Bot-Ro-Bot/Minor-Year-Project/Installation Photos/20190805_160726.jpg

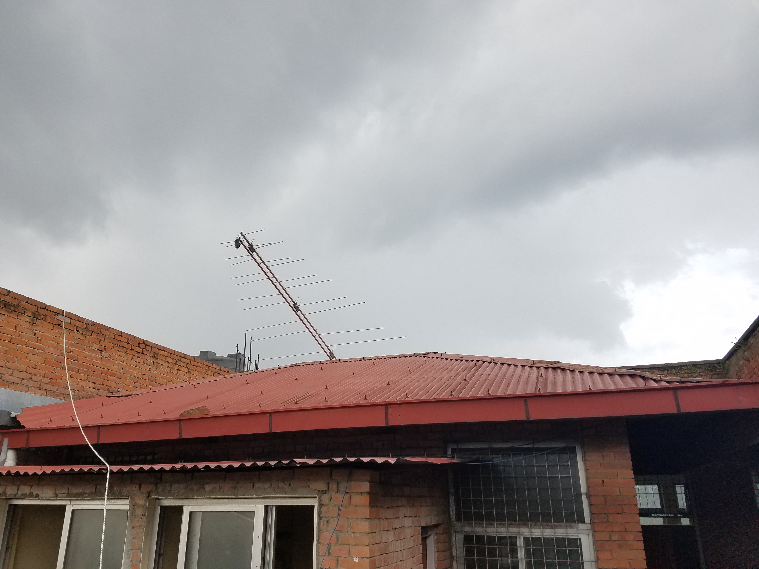
Installation Photos/20190805_160726.jpg
