Bot-Ro-Bot/Minor-Year-Project/Installation Photos/20190728_180228.jpg

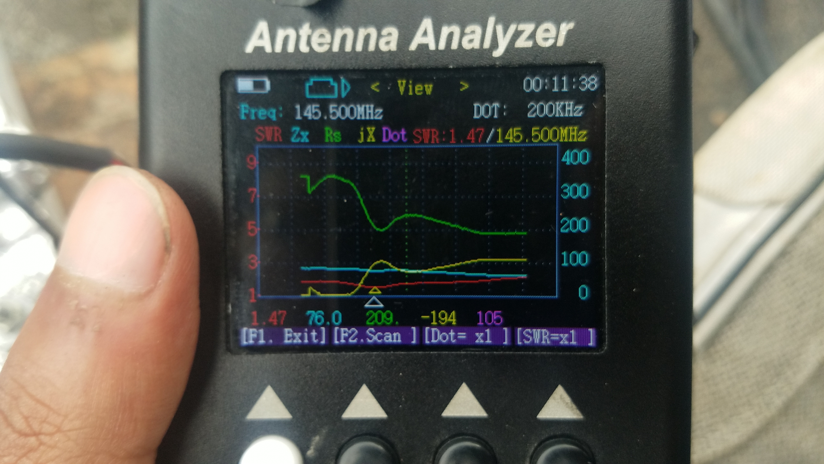
Installation Photos/20190728_180228.jpg
