Bot-Ro-Bot/Minor-Year-Project/Documentation/Proposal Defence.pptx

## Visualization of Solar Spectrum

Team members:
Rabin Nepal [073/BEX/331]
Rimesh Lawgun [073/BEX/333
Sanjay Rijal [073/BEX/342]
Upendra Subedi [073/BEX/347]

## Presentation Outline

- Motivation
- Objectives
- Scope of the Project
- Proposed Methodology
  - Instrumentation
    - Hardware
    - Software
- Expected Result
- Project Application
- Tentative Timeline
- Tentative Project Budget
- References

## Motivation

- e-Callisto project.
- Solar radiation and Aerosol in Himalaya Region (SAHR).
- Solar and Wind Energy Resource Assessment in Nepal (SWERA).

## Objectives

- To design and develop an instrumentation system for measuring solar irradiance.
- To analyze the relationship of solar irradiance with frequency and time.

## Scope of Project

- Weather forecasting.
- Solar Radiation Management (SRM).

## Proposed Methodology

- System Block Diagram:
Fig: System Block Diagram

Amplifier circuit

Filter circuit

Antenna

ADC

MatLab

Microcontroller

## Proposed Methodology [Contd..]

- Instrumentation:
  1. Hardware:
    a. Antenna
    b. Amplifier
    c. Microcontroller

## Proposed Methodology [Contd..]

- Instrumentation:
2. Software:
    a. MatLab
    b. AVR-GCC
    c. AVRDUDE

## Expected Results

- Detect solar spectrum.
- Visualization of data through graph.
- Post data analysis.

## Project Application

- Weather forecasting.
- Solar panels installation.
- Human settlement modelling.
- Radio Blackout.

## Tentative Timeline

## Tentative Project Budget

S.N. | Title | Price (Rs.)
1. | Antenna | 4,000
2. | Microcontroller | 1,000
3. | Miscellaneous | 3,000
| Total | 8,000

## References [IEEE]:

- M. O. Ali, Z. S. Hamidi, N. N. M. Shariff, M. S. Faid, S. N. U. Sabri, N. Husien, N. H. Zainol C. Monstein, e-CALLISTO Network System and the Observation of Structure of Solar Radio Burst Type III, February 2017.
- Center for Energy Studies, Institute of Engineering, Tribhuvan University, Lalitpur, Solar Mapping in Nepal, 2001.

## Thank You!!
