Bot-Ro-Bot/Minor-Year-Project/Resources/Import List - Google Docs.pdf

SN | Product | Product link | Quantity (in pieces) | Description
1 | NE602 | https://www.alibaba.com/product-detail/NE 602N-Integrated-Circuit-NE602-balanced-mixer_60823970438.html?spm=a2700.77 24857.normalList.53.55714cc3zelDTC (https://www.alibaba.com/product-detail/NE602N-Integrated-Circuit-NE602-balanced-mixer_60823970438.html) | 6 | Mixer IC
2 | AD8307 | https://www.alibaba.com/product-detail/Co mponent-AD8307ANZ-IC-LOGARITHMIC-AMP-8_60839842723.html?spm=a2700.7 724838.2017115.37.30e740b2k16BCf (https://www.alibaba.com/product-detail/Component-AD8307ANZ-IC-LOGARITHMIC-AMP-8_60839842723.html) | 6 | Log Amplifier
3 | 25LC320 | https://www.alibaba.com/product-detail/25LC320-P-EEPROM-4kx8_62196204528.html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 837410hc0DHE (https://www.alibaba.com/product-detail/25LC320-P-EEPROM-4kx8_62196204528.html) | 2 | Memory
4 | CD1316L S/IV3 | https://www.ebay.com/itm/CD1316LS-IV-3-New-Philips-NXP-TV-Tuner-/4005822260 32 (https://www.ebay.com/itm/CD1316LS-IV-3-New-Philips-NXP-TV-Tuner-/400582226032) | 1 | TV Tuner
5 | BF199 | https://www.aliexpress.com/item/10pcs-BF 199-TO-92-NPN-medium-frequency-transi stor/32455962390.html?spm=a2g0o.produ ctlist.0.0.3d2f2af3BcEc2D&algo_pvid=058 7c4f1-1b22-4941-a727-30ccf9ea537f&alg o_expid=0587c4f1-1b22-4941-a727-30ccf 9ea537f-0&btsid=1bc008d1-9964-488c-b5 93-852ad4bd04ba&ws_ab_test=searchwe b0_0,searchweb201602_1,searchweb201 603_52 (https://www.aliexpress.com/item/10pcs-BF199-TO-92-NPN-medium-frequency-transistor/32455962390.html) | 6 | NPN RF Transistor
