Bot-Ro-Bot/Minor-Year-Project/Codes/references/P45_n2.9.1/LCD.png

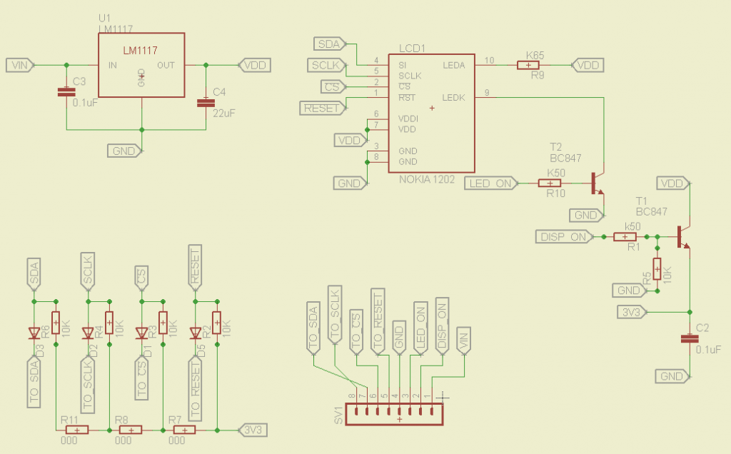
Codes/references/P45_n2.9.1/LCD.png
