Bot-Ro-Bot/Minor-Year-Project/Codes/references/P45_n2.9.1/m168_fuse.png

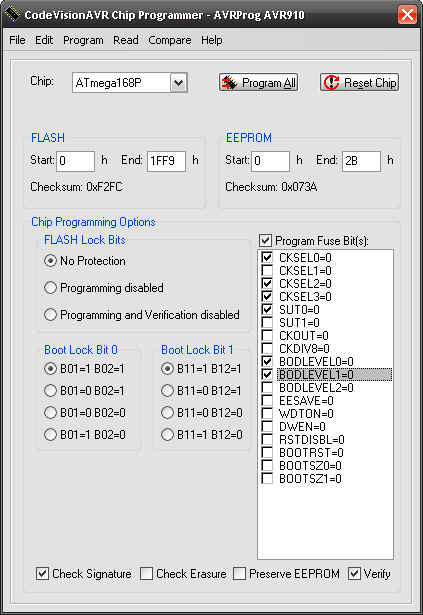
Codes/references/P45_n2.9.1/m168_fuse.png
