Bot-Ro-Bot/Minor-Year-Project/Codes/references/P45_n2.9.1/mega168_n1202_power.png

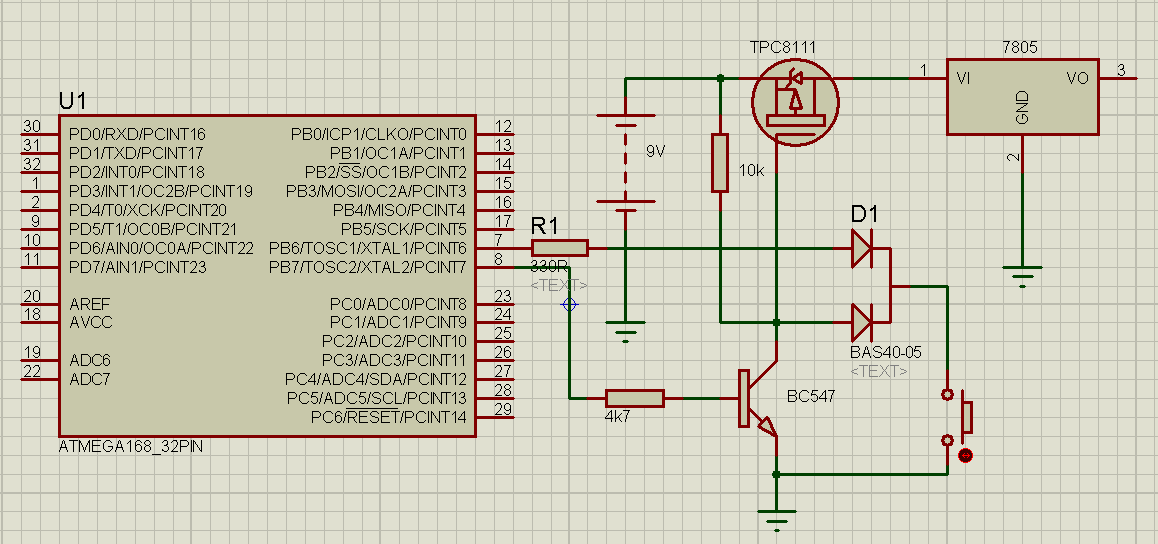
Codes/references/P45_n2.9.1/mega168_n1202_power.png
