Bot-Ro-Bot/Minor-Year-Project/Codes/references/P45_n2.9.1/p45.png

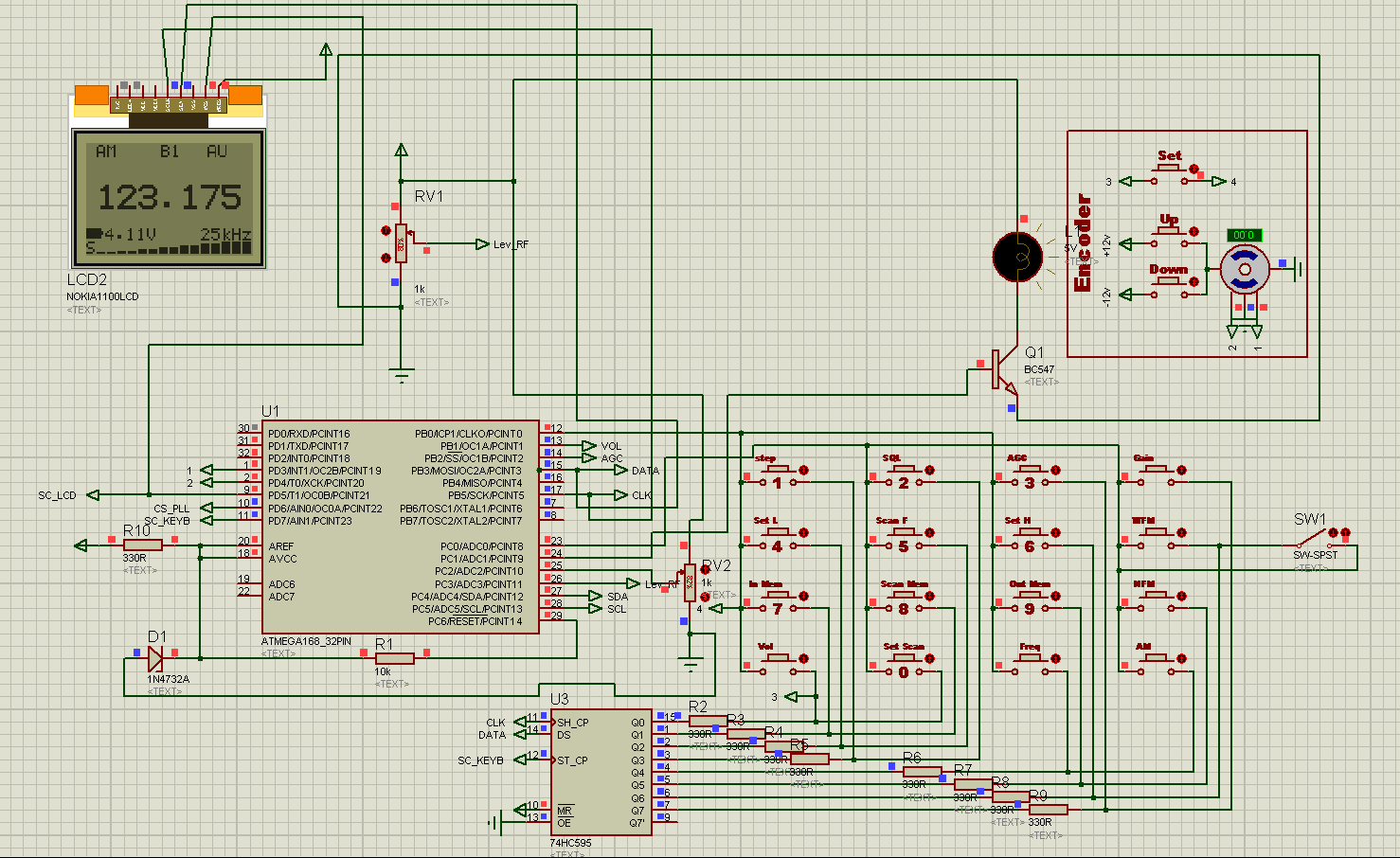
Codes/references/P45_n2.9.1/p45.png
