Bot-Ro-Bot/Minor-Year-Project/Resources/20171007_091135.jpg

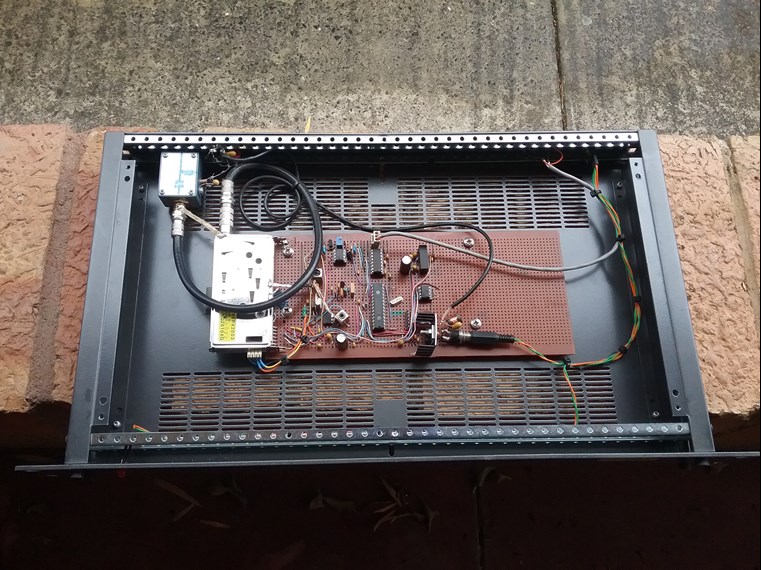
Resources/20171007_091135.jpg
