Bot-Ro-Bot/Minor-Year-Project/Installation Photos/20190711_205909.jpg

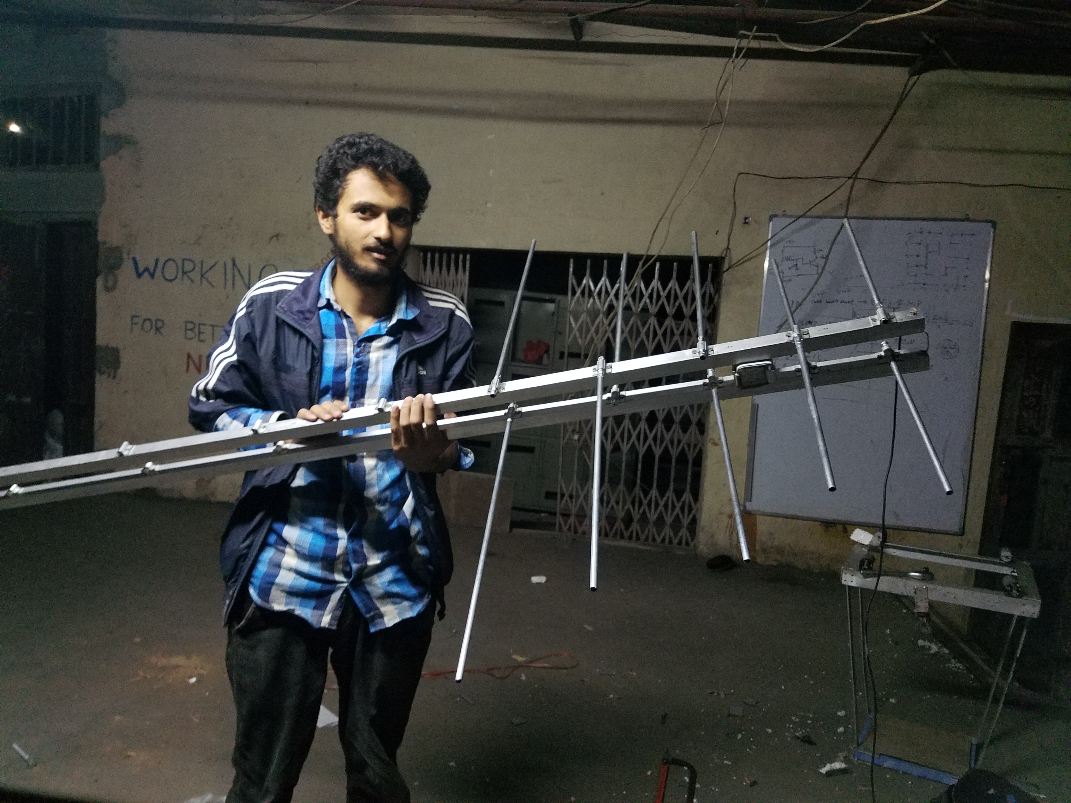
Installation Photos/20190711_205909.jpg
