Bot-Ro-Bot/Minor-Year-Project/Installation Photos/20190711_205954.jpg

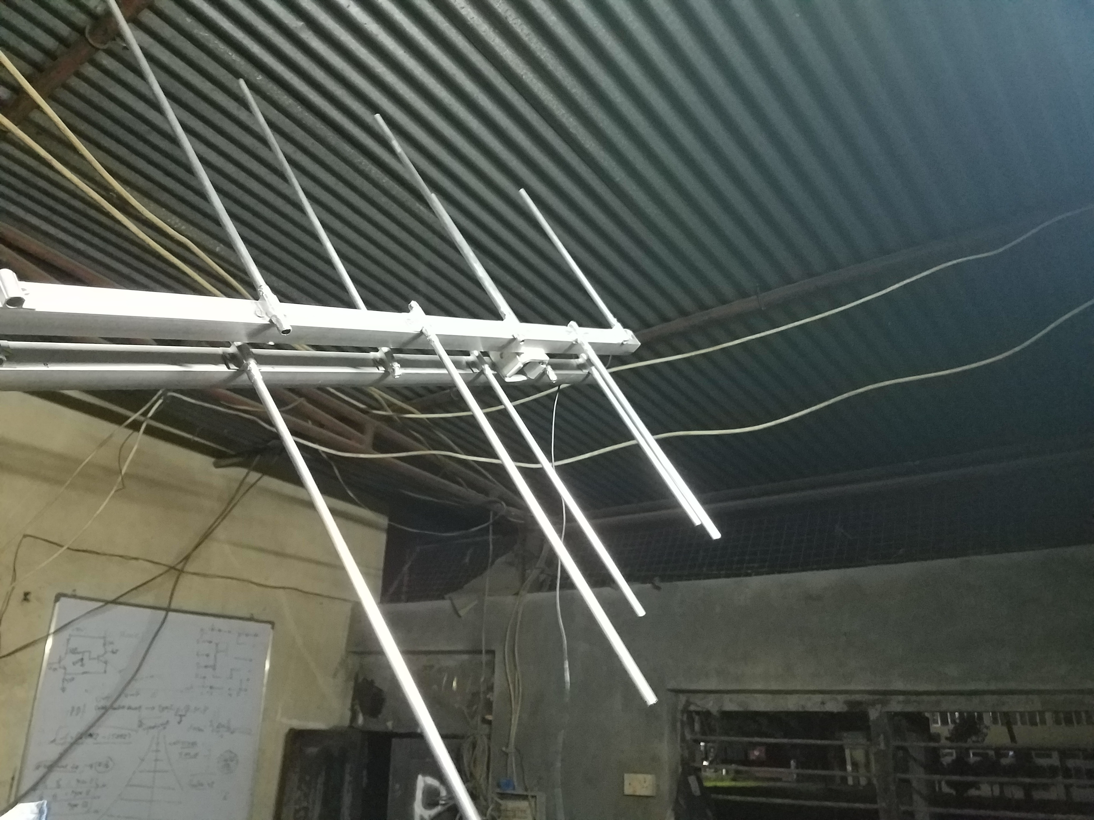
Installation Photos/20190711_205954.jpg
