Bot-Ro-Bot/Minor-Year-Project/Installation Photos/20190711_210047.jpg

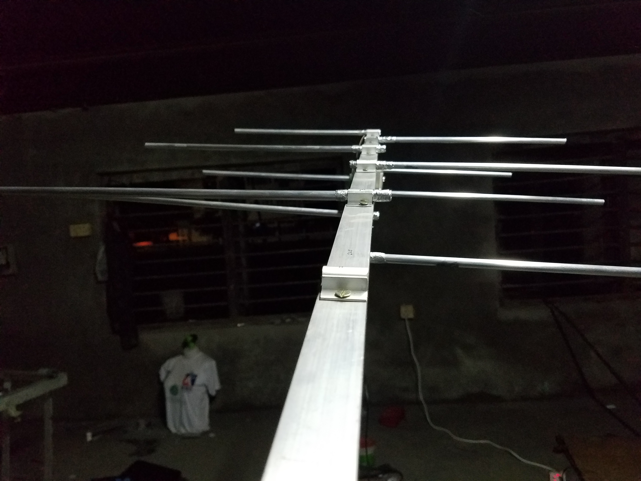
Installation Photos/20190711_210047.jpg
