Bot-Ro-Bot/Minor-Year-Project/Installation Photos/20190711_210103.jpg

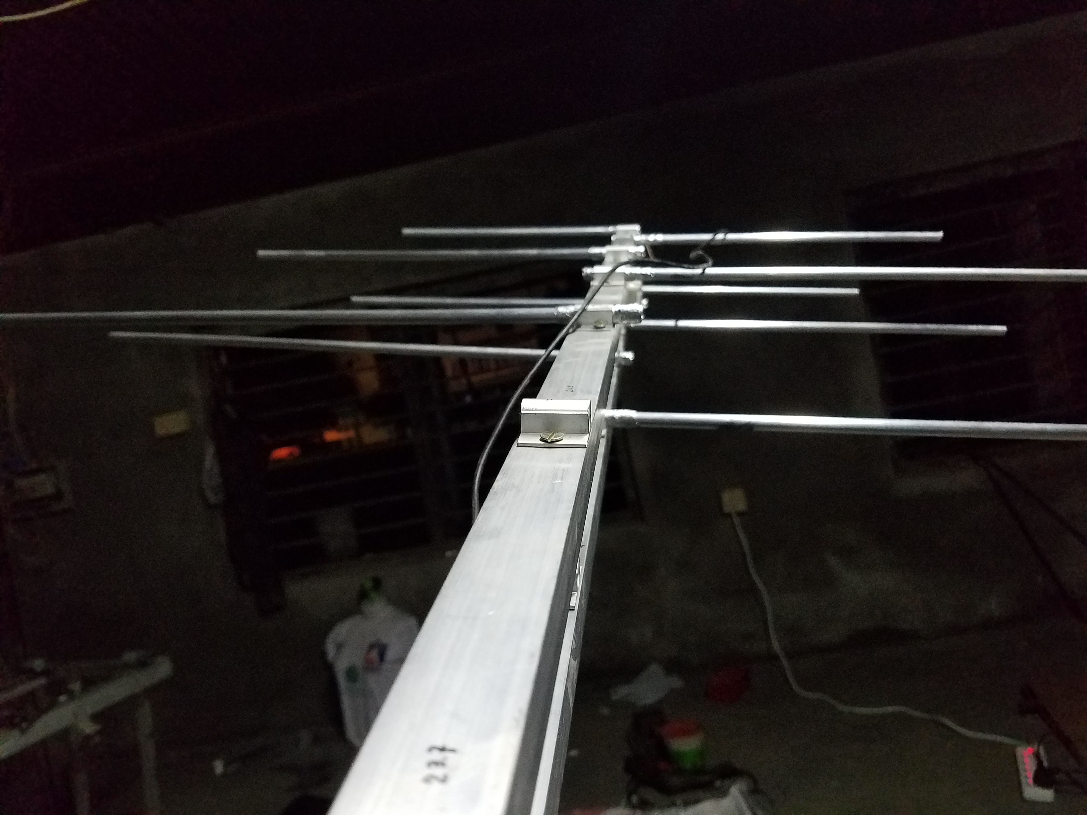
Installation Photos/20190711_210103.jpg
