Bot-Ro-Bot/Minor-Year-Project/Installation Photos/20190713_214556.jpg

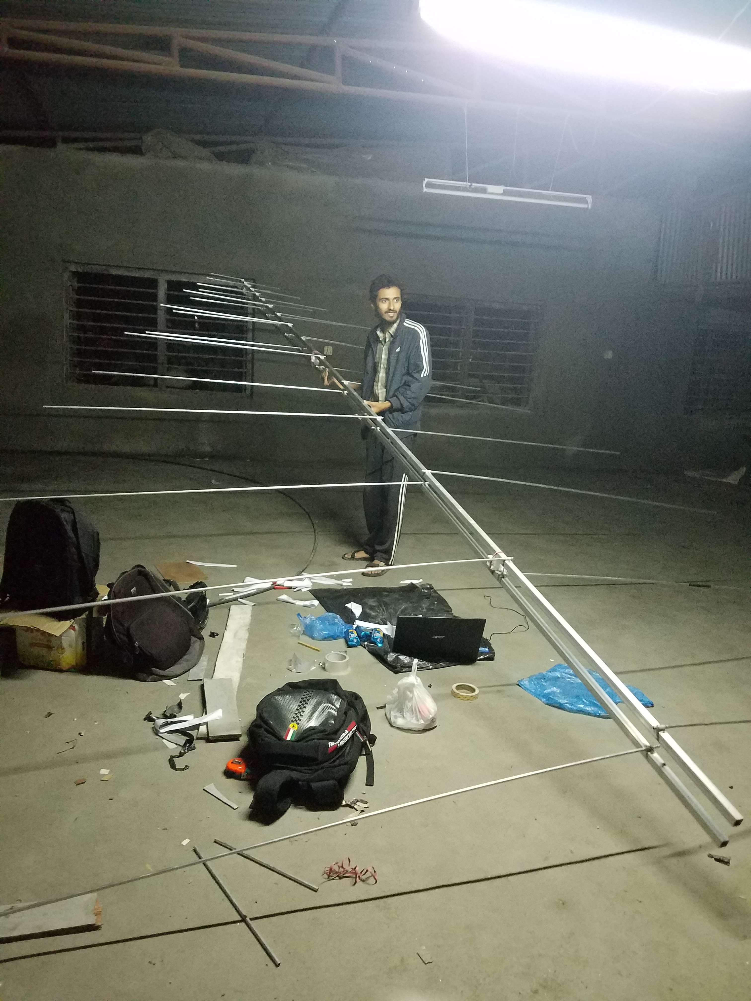
Installation Photos/20190713_214556.jpg
