Bot-Ro-Bot/Minor-Year-Project/Installation Photos/20190713_214613.jpg

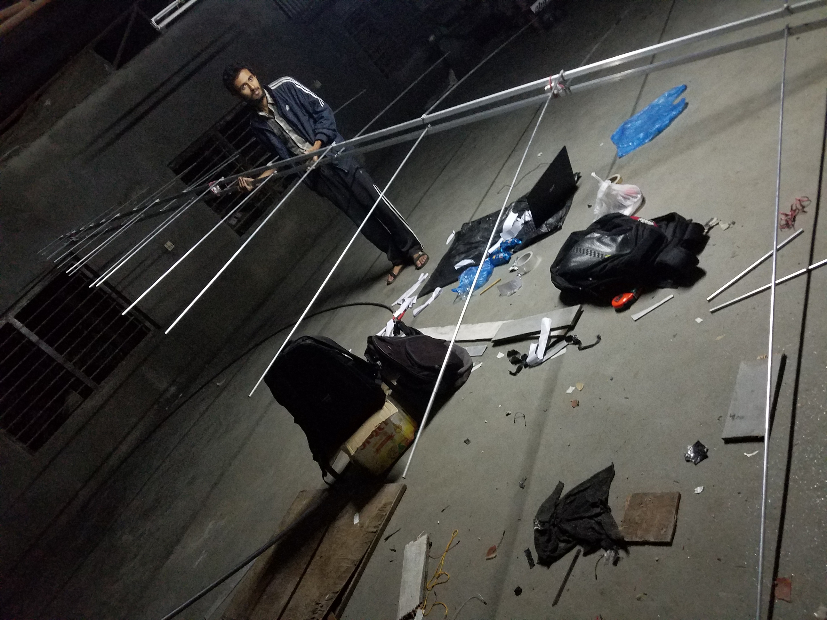
Installation Photos/20190713_214613.jpg
