Bot-Ro-Bot/Minor-Year-Project/Installation Photos/20190713_214659.jpg

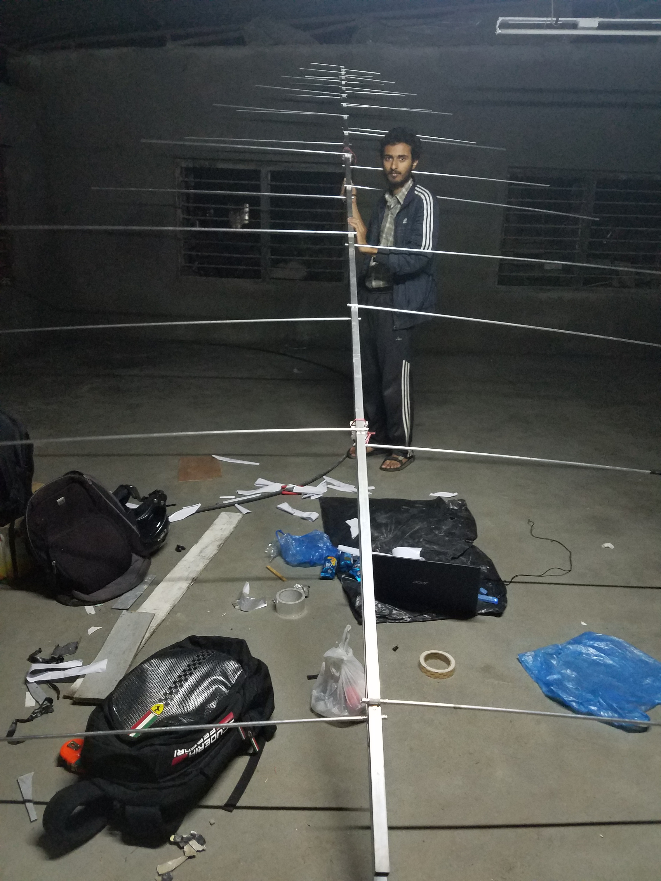
Installation Photos/20190713_214659.jpg
