Bot-Ro-Bot/Minor-Year-Project/Installation Photos/20190718_143614.jpg

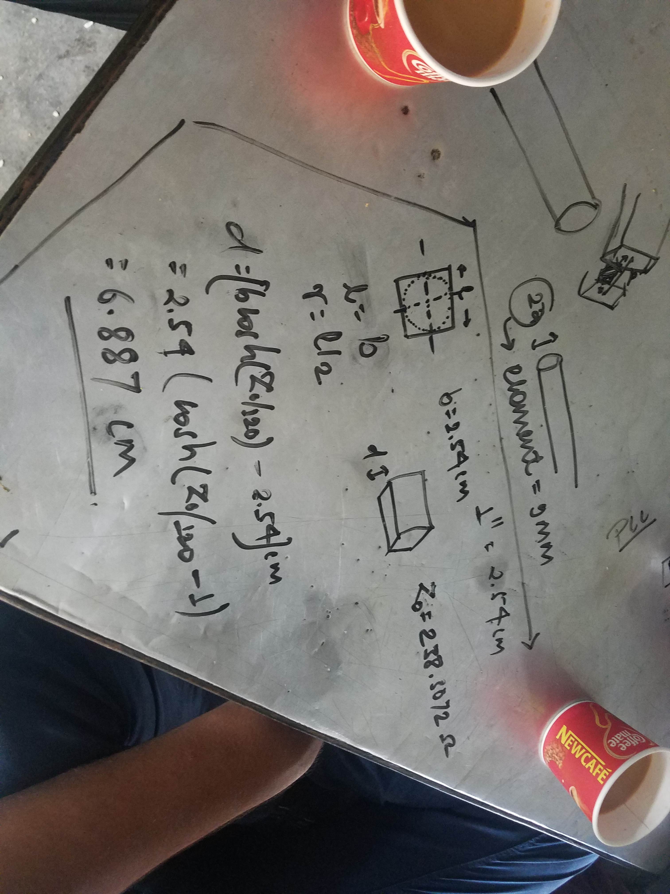
Installation Photos/20190718_143614.jpg
