Bot-Ro-Bot/Minor-Year-Project/Installation Photos/20190718_152357.jpg

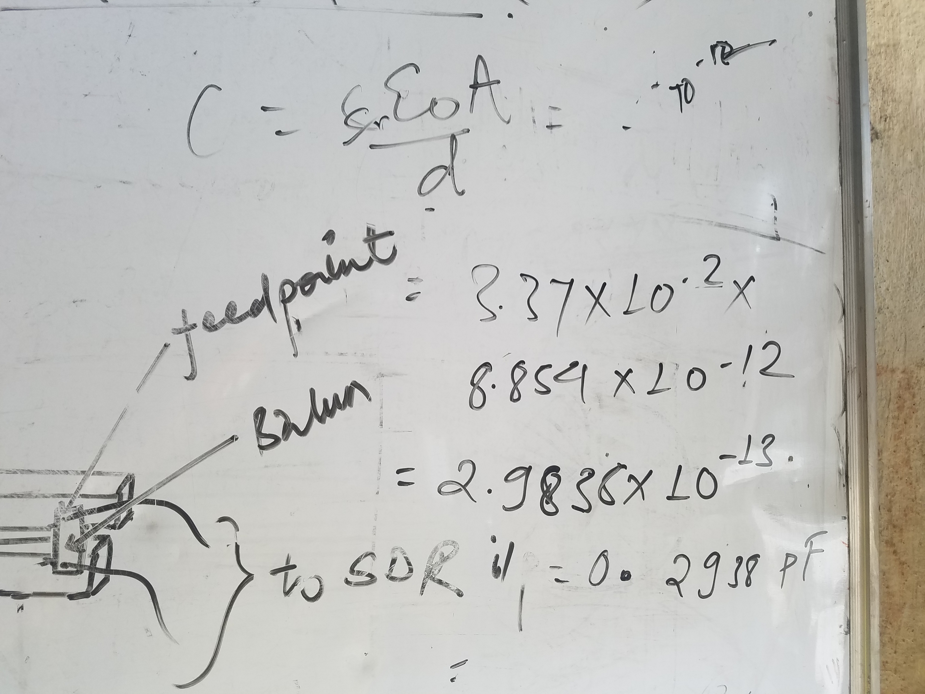
Installation Photos/20190718_152357.jpg
