Bot-Ro-Bot/Minor-Year-Project/Installation Photos/20190723_160248.jpg

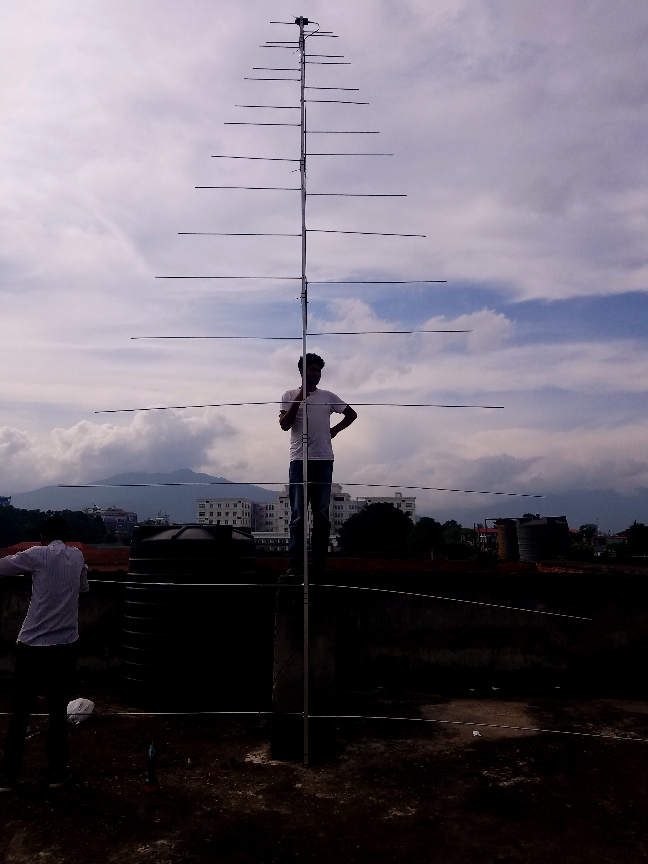
Installation Photos/20190723_160248.jpg
