Bot-Ro-Bot/Minor-Year-Project/Installation Photos/20190728_155337.jpg

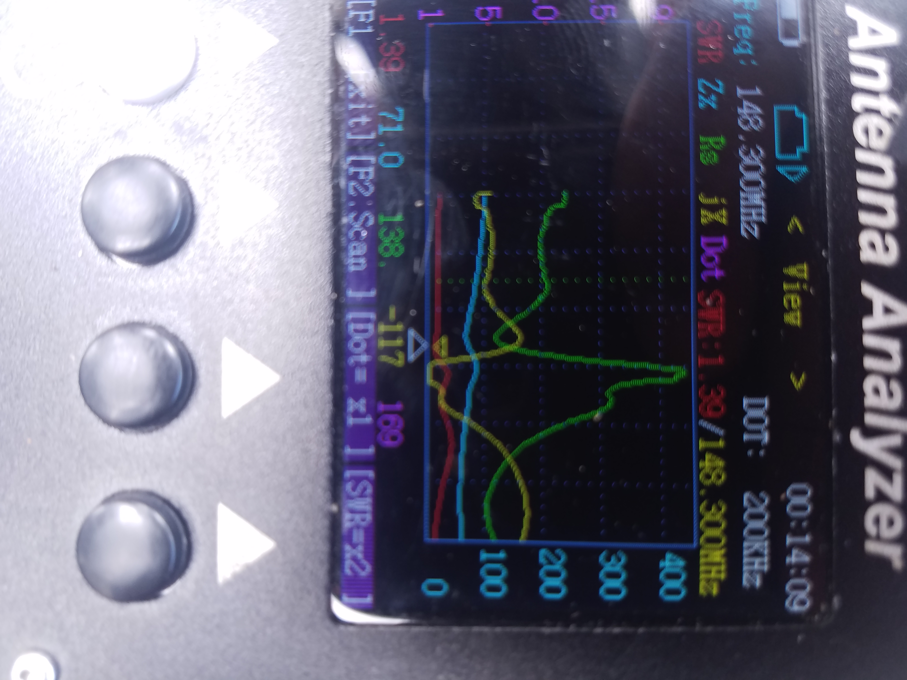
Installation Photos/20190728_155337.jpg
