Bot-Ro-Bot/Minor-Year-Project/Installation Photos/20190728_155429.jpg

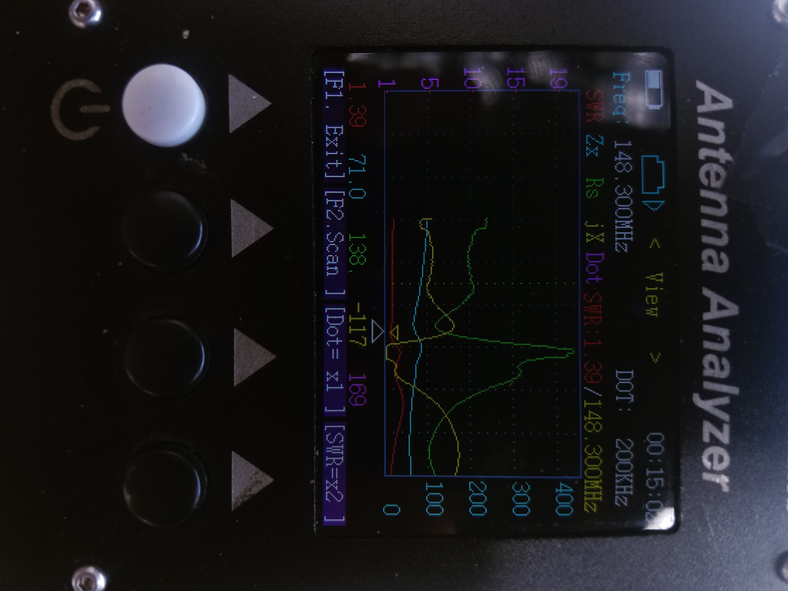
Installation Photos/20190728_155429.jpg
