Bot-Ro-Bot/Minor-Year-Project/Installation Photos/20190728_163552.jpg

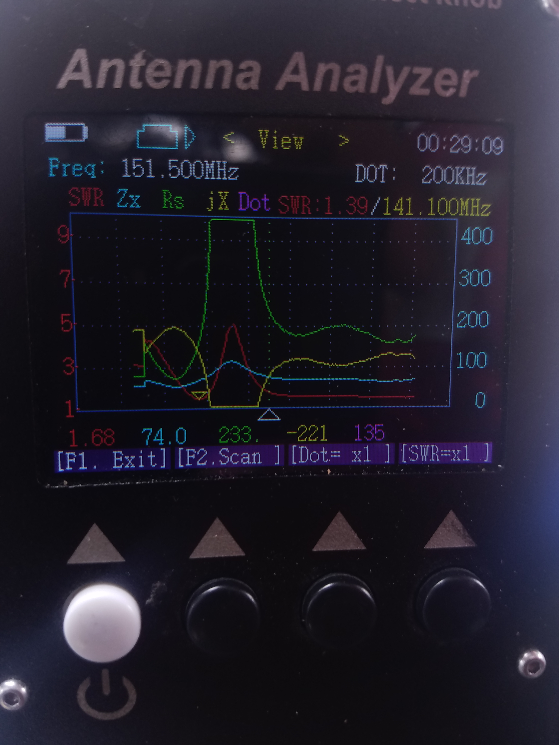
Installation Photos/20190728_163552.jpg
