Bot-Ro-Bot/Minor-Year-Project/Installation Photos/20190728_175439.jpg

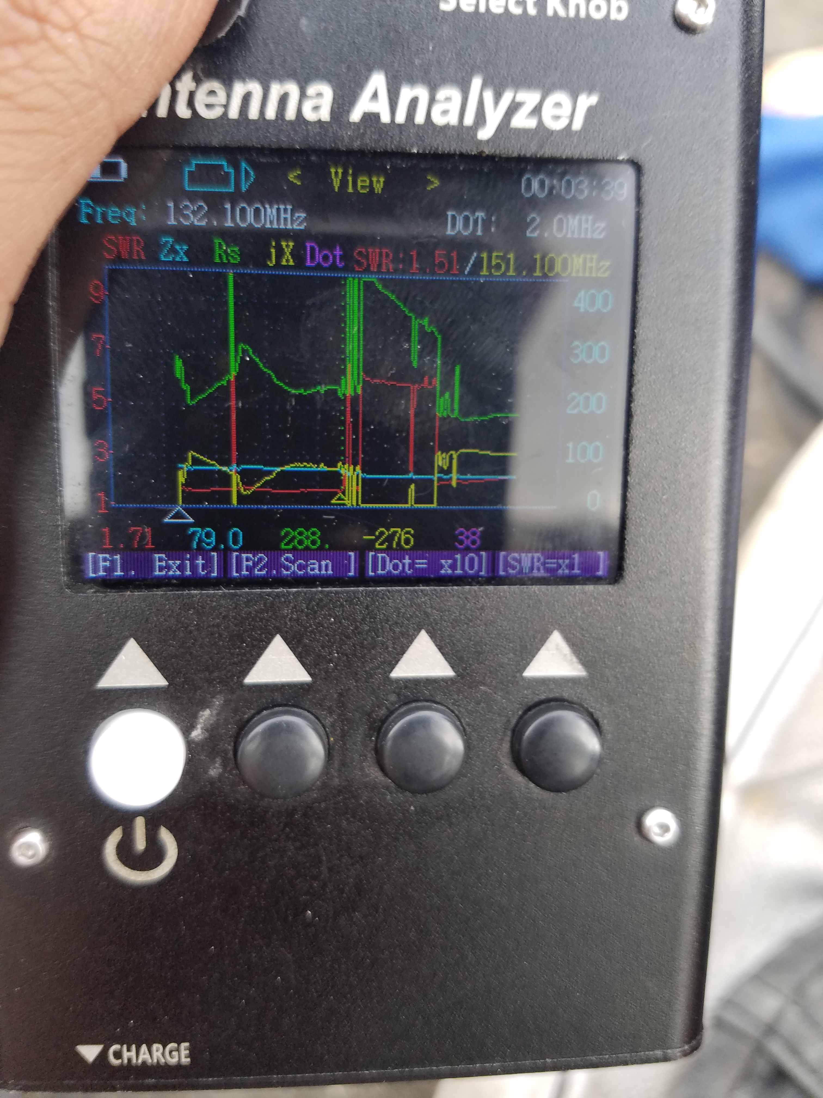
Installation Photos/20190728_175439.jpg
