Bot-Ro-Bot/Minor-Year-Project/Installation Photos/20190728_180226.jpg

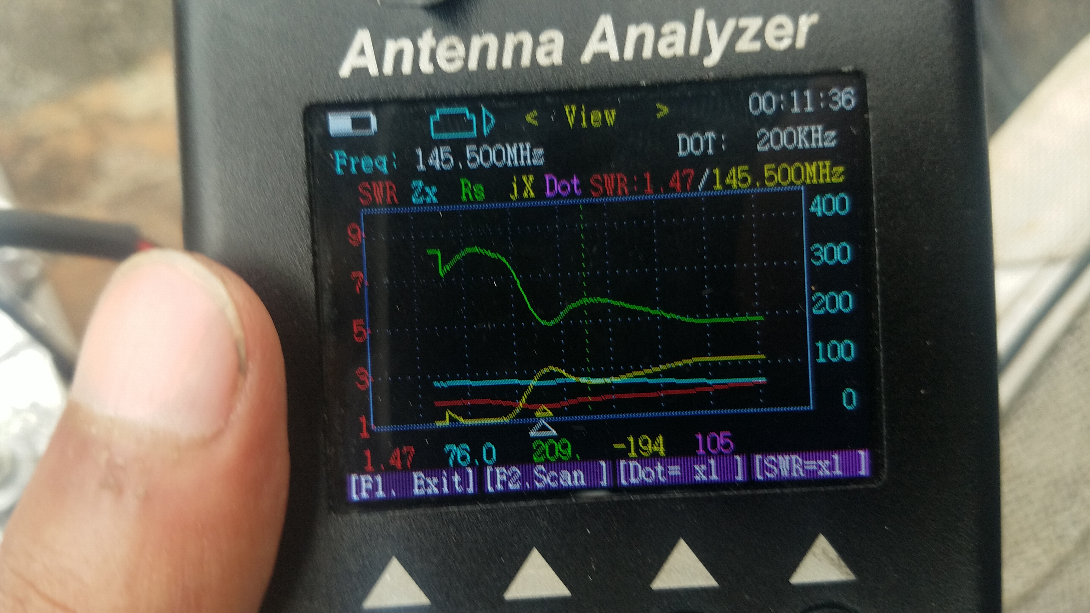
Installation Photos/20190728_180226.jpg
