Bot-Ro-Bot/Minor-Year-Project/Installation Photos/20190728_180300.jpg

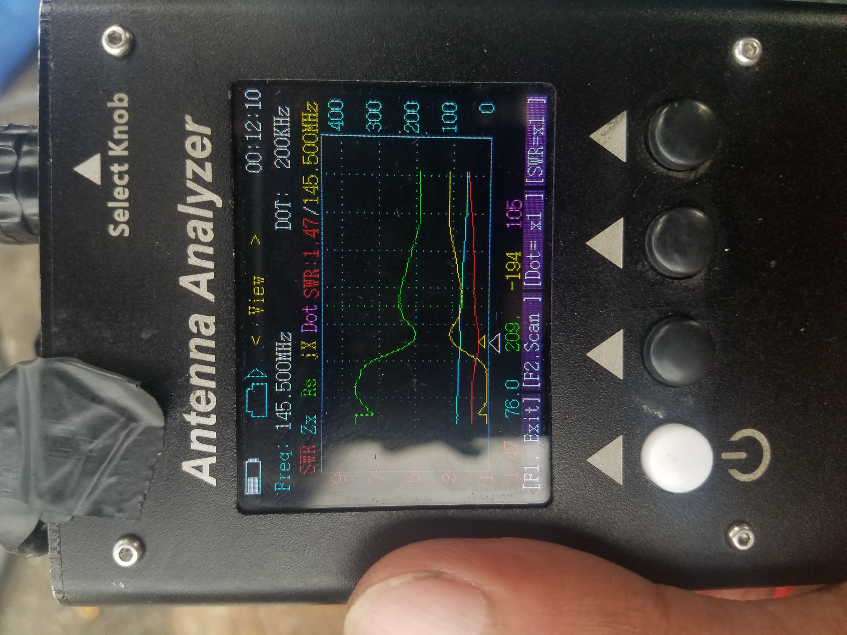
Installation Photos/20190728_180300.jpg
