Bot-Ro-Bot/Minor-Year-Project/Installation Photos/20190728_180326.jpg

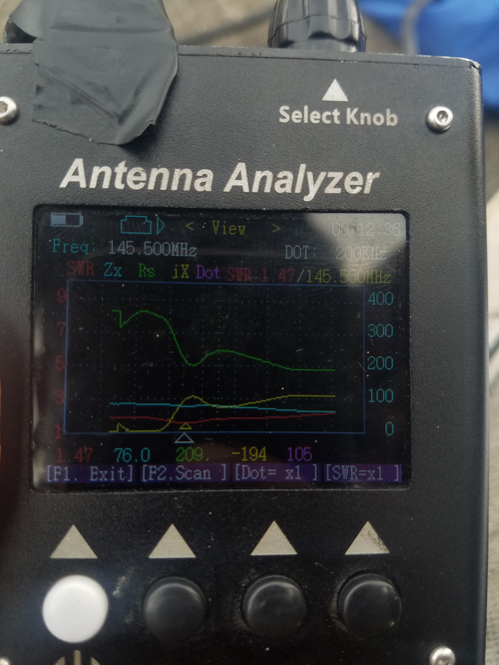
Installation Photos/20190728_180326.jpg
