Bot-Ro-Bot/Minor-Year-Project/Installation Photos/20190728_180330.jpg

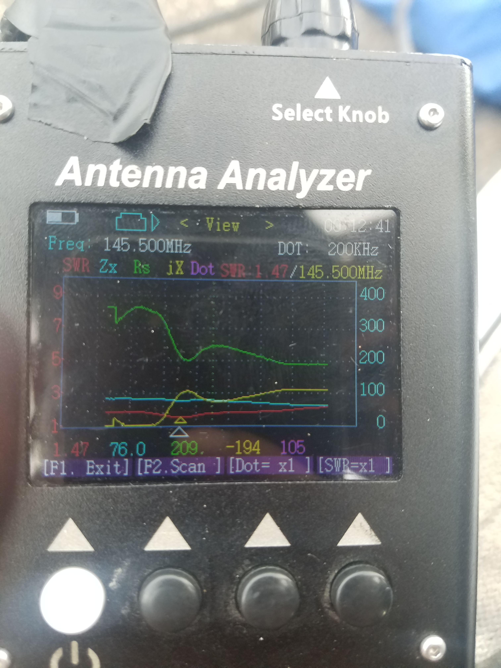
Installation Photos/20190728_180330.jpg
