Bot-Ro-Bot/Minor-Year-Project/Installation Photos/20190806_154939.jpg

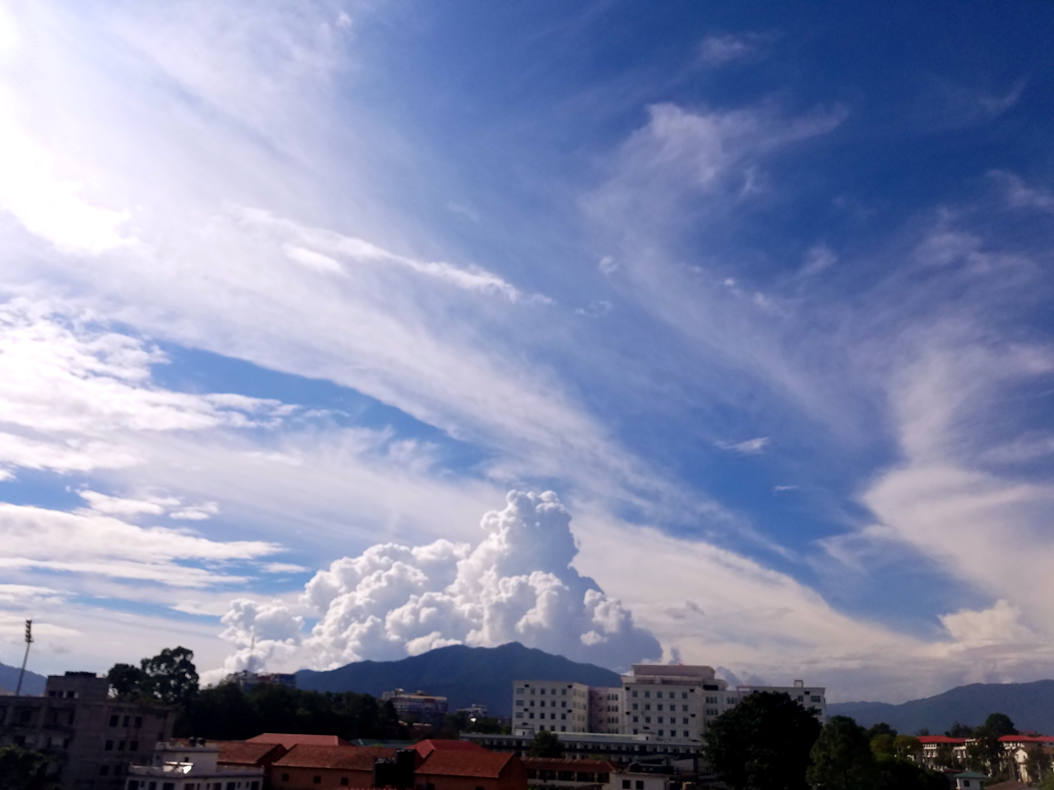
Installation Photos/20190806_154939.jpg
