Bot-Ro-Bot/Minor-Year-Project/Installation Photos/20190806_160455.jpg

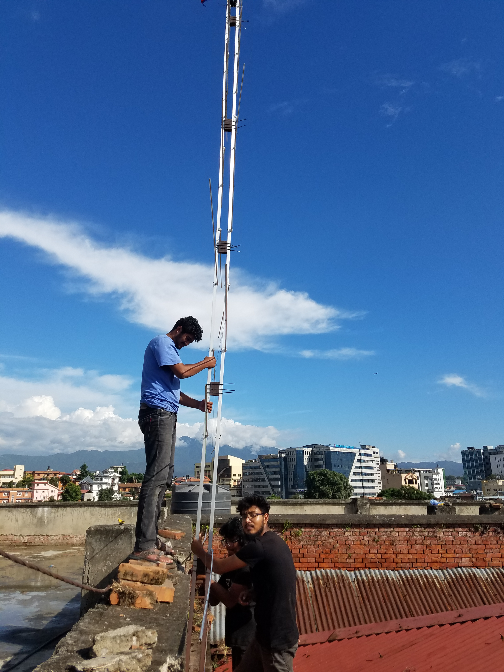
Installation Photos/20190806_160455.jpg
