Bot-Ro-Bot/Minor-Year-Project/Installation Photos/20190806_160517.jpg

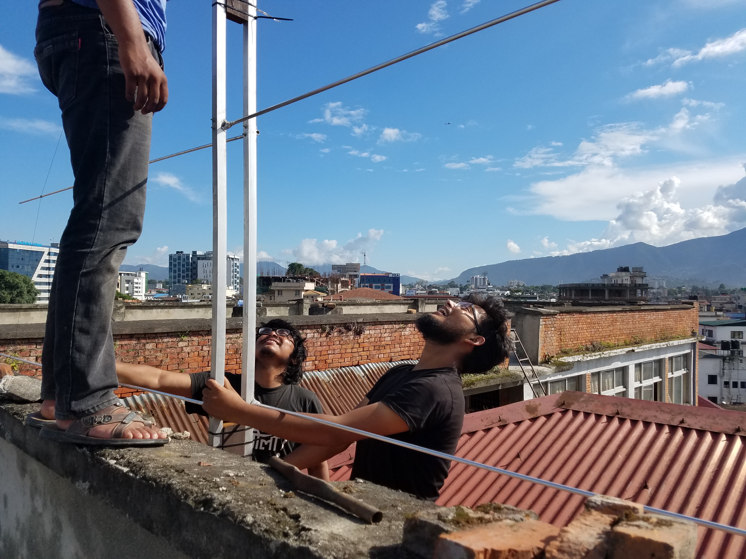
Installation Photos/20190806_160517.jpg
