Bot-Ro-Bot/Minor-Year-Project/Installation Photos/20190806_160649.jpg

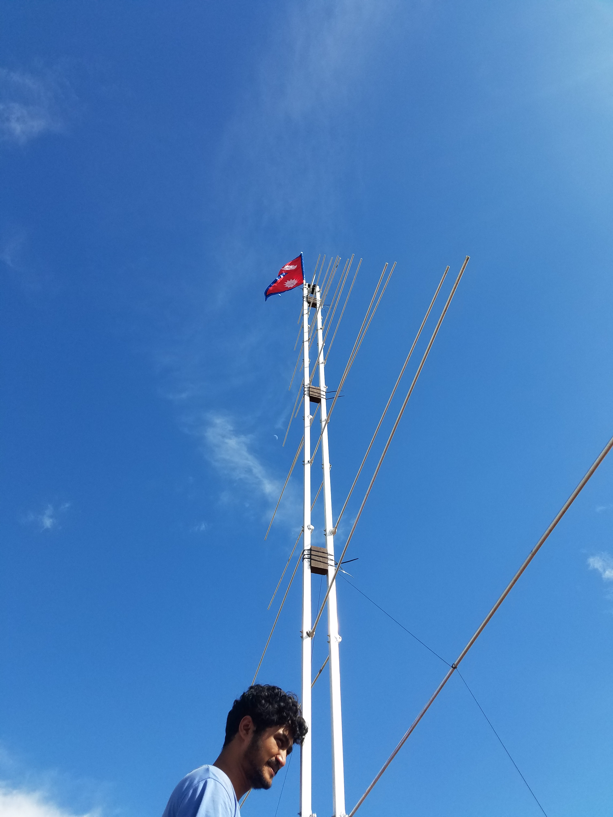
Installation Photos/20190806_160649.jpg
