Bot-Ro-Bot/Minor-Year-Project/Installation Photos/20190806_184749.jpg

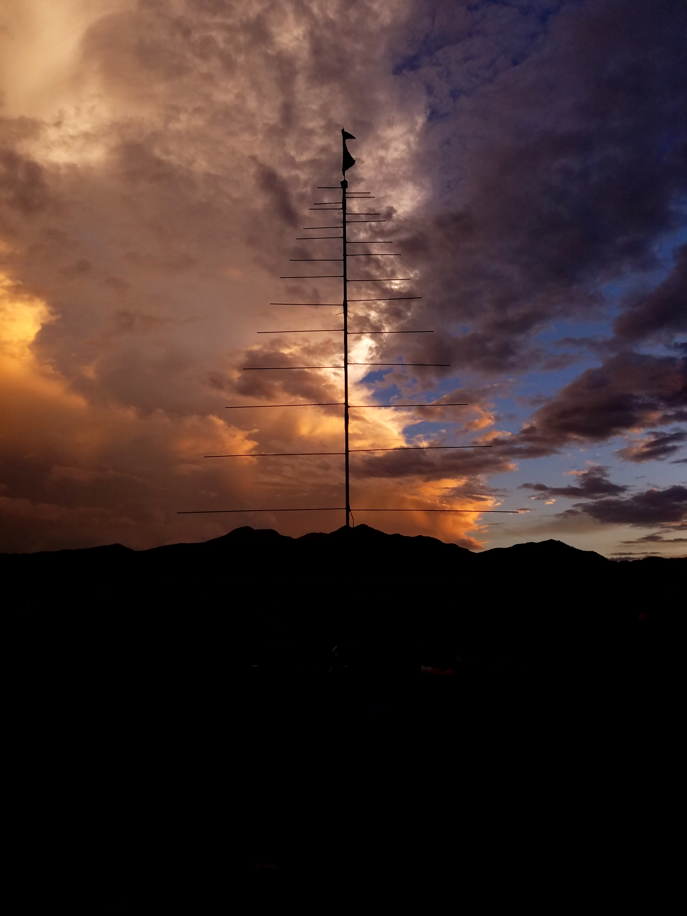
Installation Photos/20190806_184749.jpg
