Bot-Ro-Bot/Minor-Year-Project/Installation Photos/20190806_184801.jpg

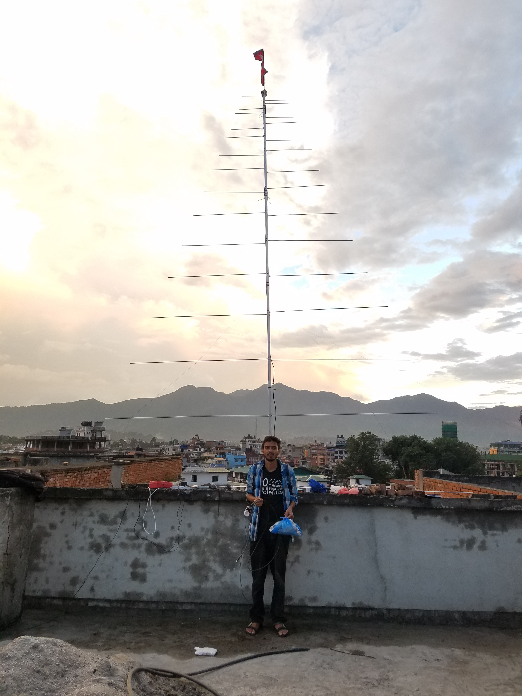
Installation Photos/20190806_184801.jpg
