Bot-Ro-Bot/Minor-Year-Project/Installation Photos/20190806_185039.jpg

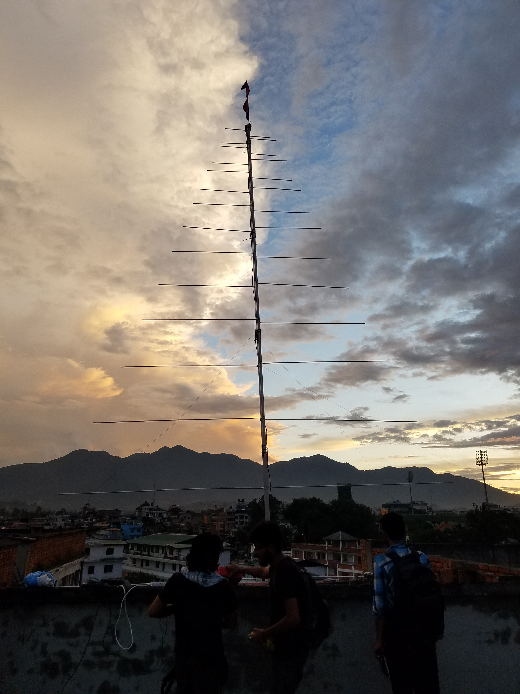
Installation Photos/20190806_185039.jpg
