Bot-Ro-Bot/Minor-Year-Project/Installation Photos/20190806_185100.jpg

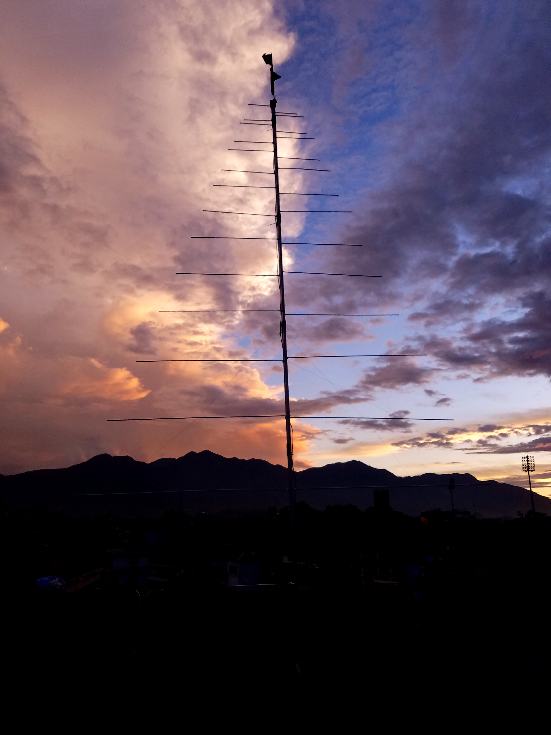
Installation Photos/20190806_185100.jpg
