Bot-Ro-Bot/Minor-Year-Project/Installation Photos/20190806_185122.jpg

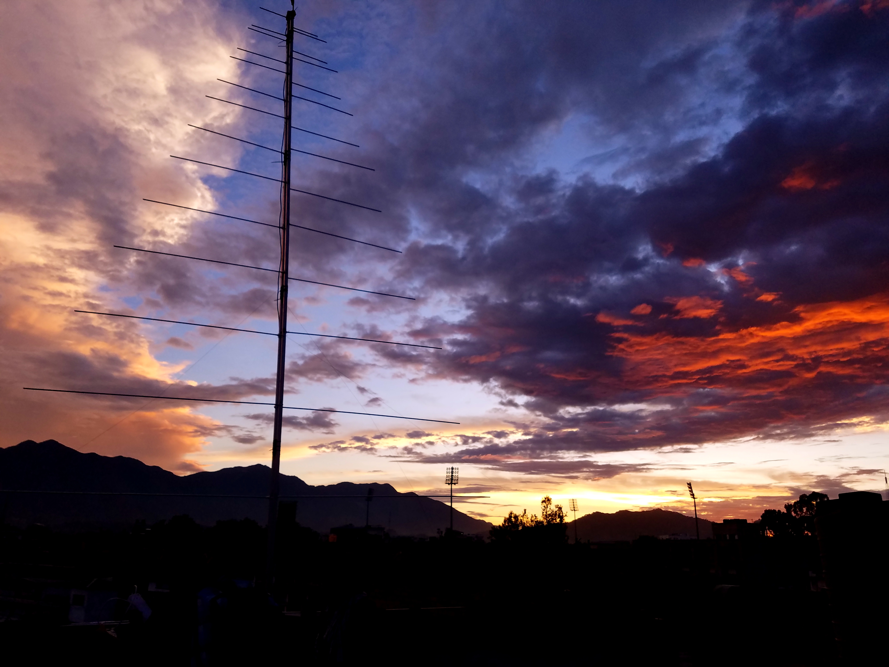
Installation Photos/20190806_185122.jpg
