Bot-Ro-Bot/Minor-Year-Project/Installation Photos/20190806_185224.jpg

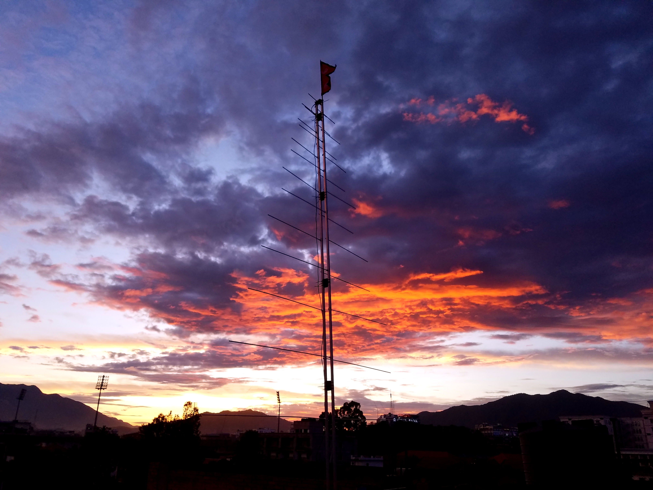
Installation Photos/20190806_185224.jpg
