Bot-Ro-Bot/Minor-Year-Project/Installation Photos/20190806_185234.jpg

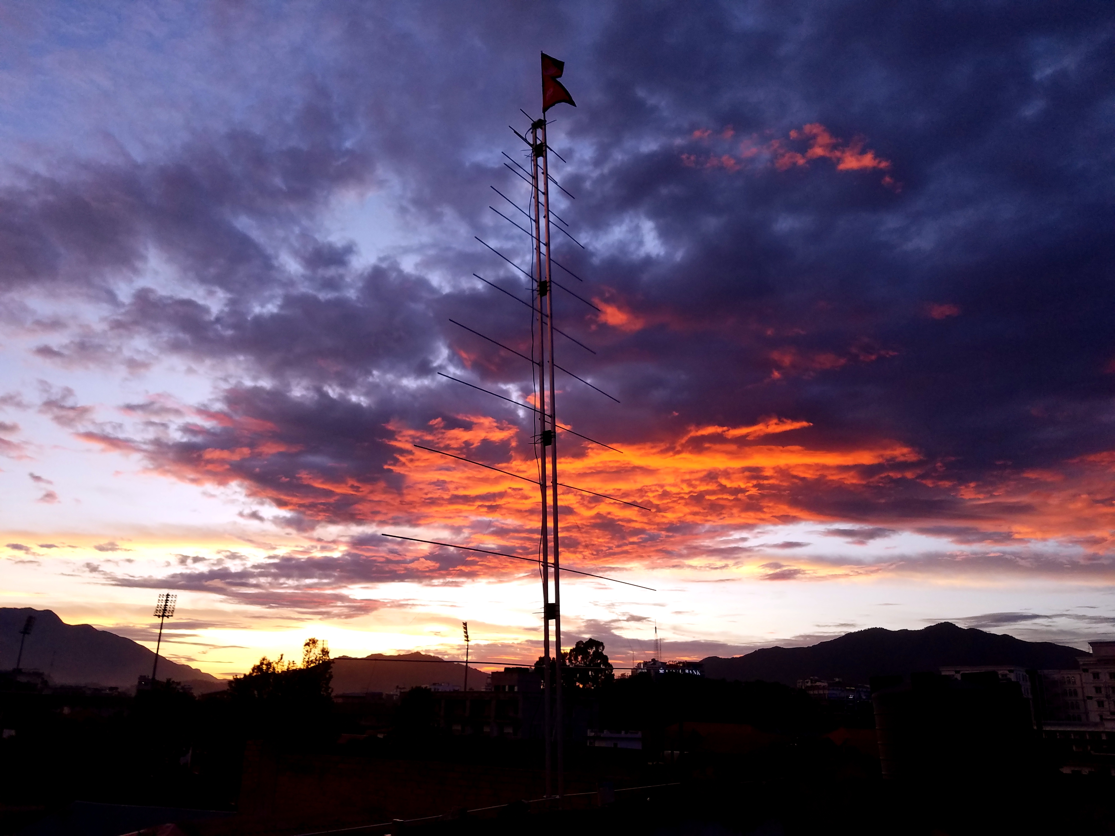
Installation Photos/20190806_185234.jpg
