Bot-Ro-Bot/Minor-Year-Project/Installation Photos/20190806_185300.jpg

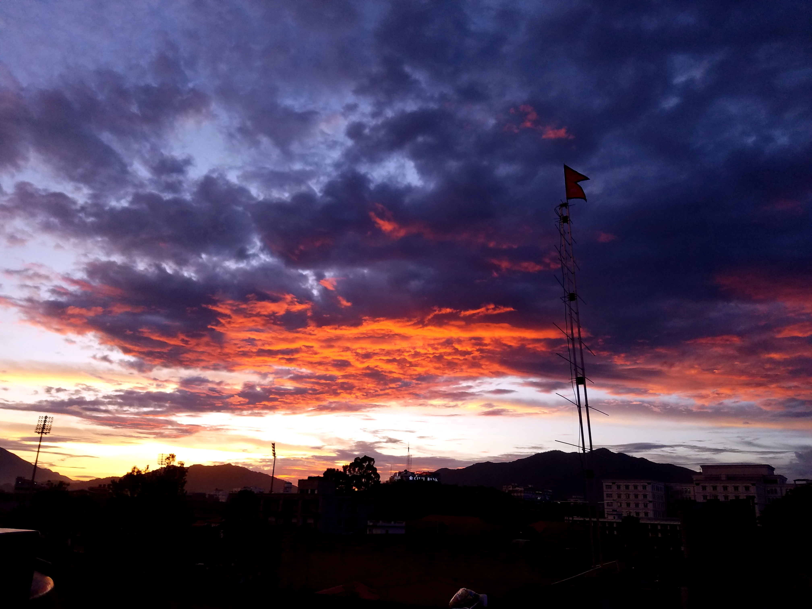
Installation Photos/20190806_185300.jpg
