Bot-Ro-Bot/Minor-Year-Project/Installation Photos/20190806_185358.jpg

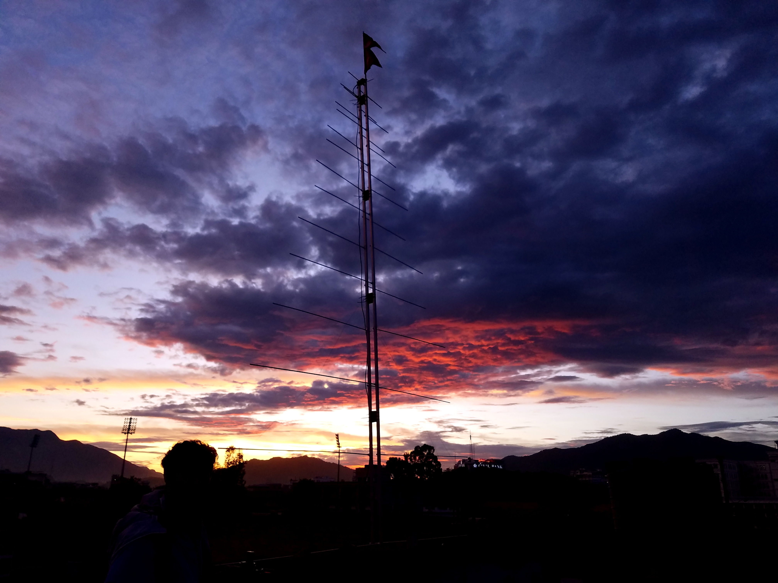
Installation Photos/20190806_185358.jpg
