Bot-Ro-Bot/Minor-Year-Project/Installation Photos/20190806_185517.jpg

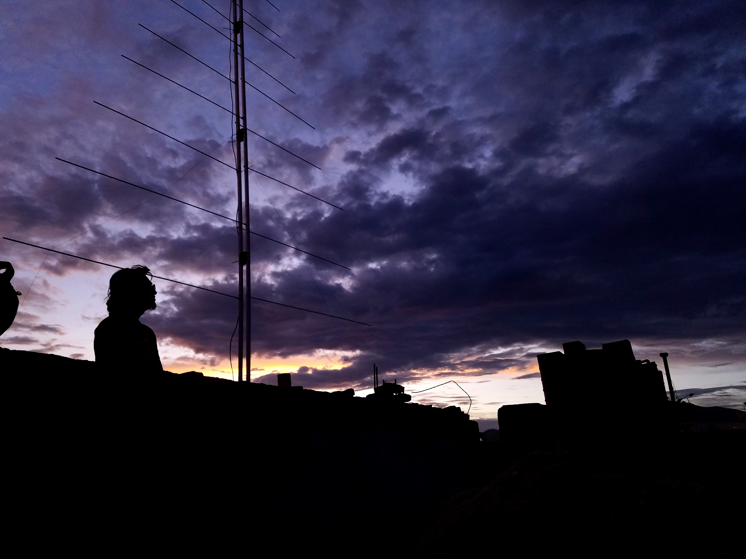
Installation Photos/20190806_185517.jpg
