Bot-Ro-Bot/Minor-Year-Project/Installation Photos/20190807_120409.jpg

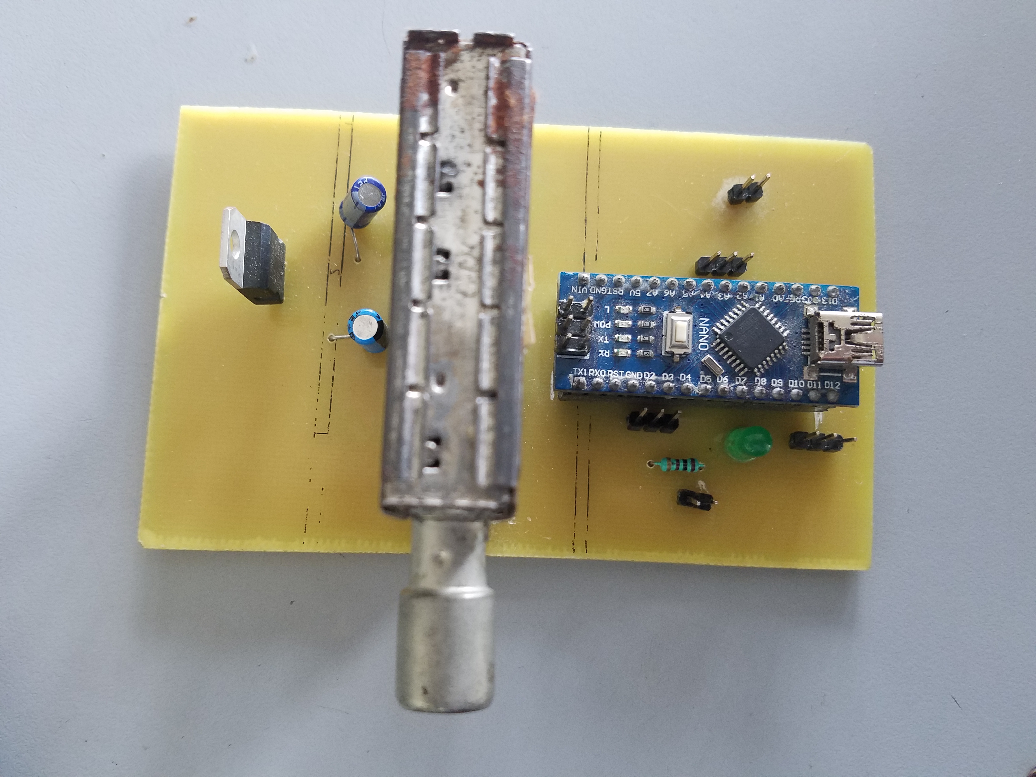
Installation Photos/20190807_120409.jpg
