Bot-Ro-Bot/Minor-Year-Project/Installation Photos/Antenna_Pokhara.jpg

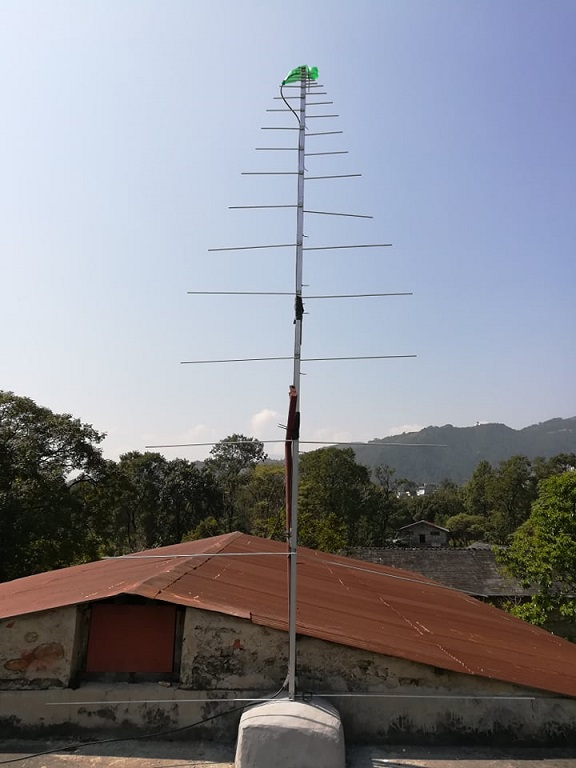
Installation Photos/Antenna_Pokhara.jpg
