Bot-Ro-Bot/Minor-Year-Project/Installation Photos/IMG-9a9eada8c8bfd724b7b04097ae08b283-V.jpg

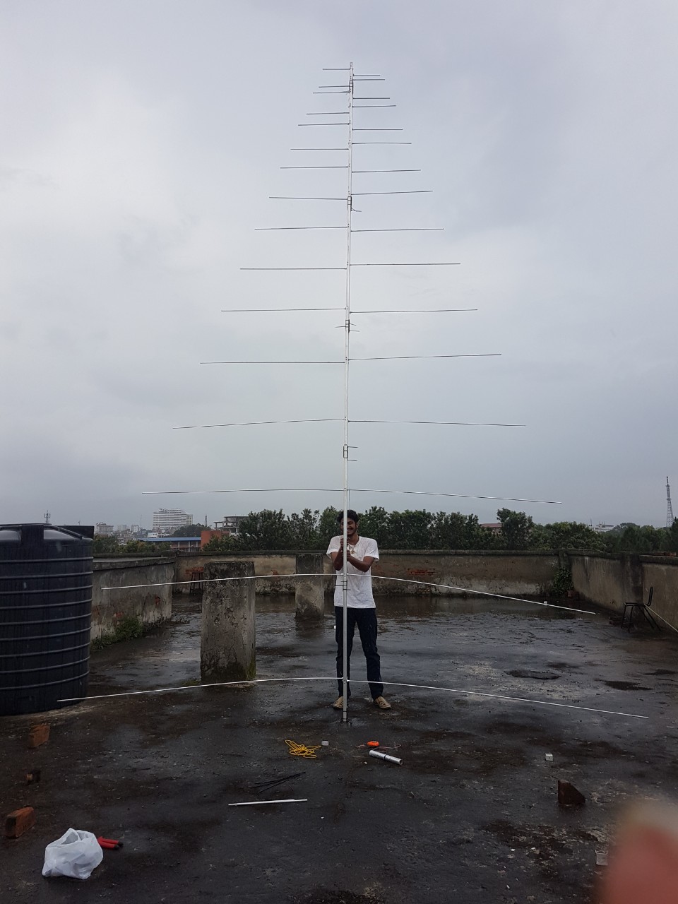
Installation Photos/IMG-9a9eada8c8bfd724b7b04097ae08b283-V.jpg
