Bot-Ro-Bot/Minor-Year-Project/Installation Photos/IMG-7666c216e2842322c7813b1267e6877e-V.jpg

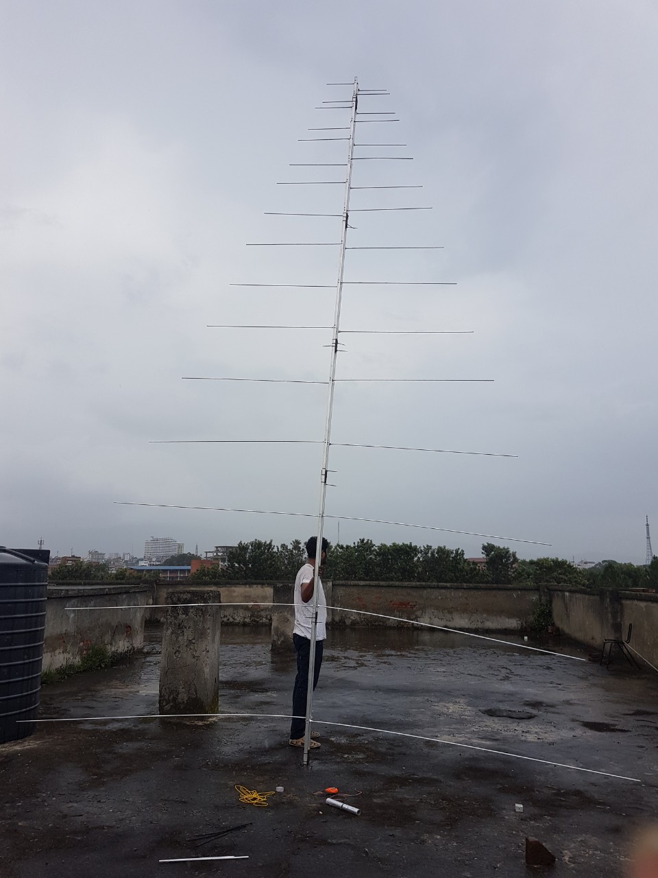
Installation Photos/IMG-7666c216e2842322c7813b1267e6877e-V.jpg
