Bot-Ro-Bot/Minor-Year-Project/Installation Photos/IMG-370901ca95b27fd834240853d4fb4564-V.jpg

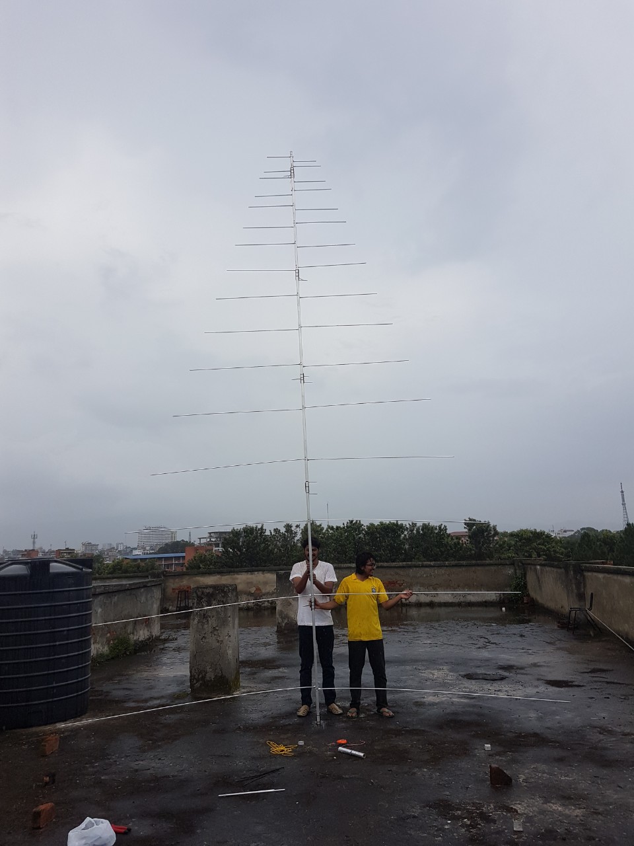
Installation Photos/IMG-370901ca95b27fd834240853d4fb4564-V.jpg
