Bot-Ro-Bot/Minor-Year-Project/Installation Photos/20190723_144531.jpg

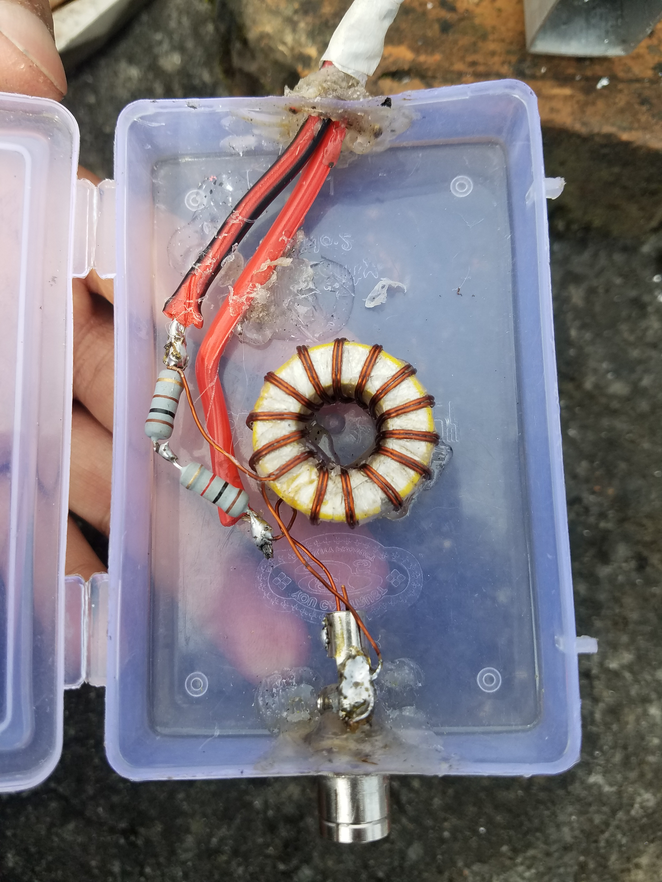
Installation Photos/20190723_144531.jpg
