Bot-Ro-Bot/Minor-Year-Project/Installation Photos/20190806_160441.jpg

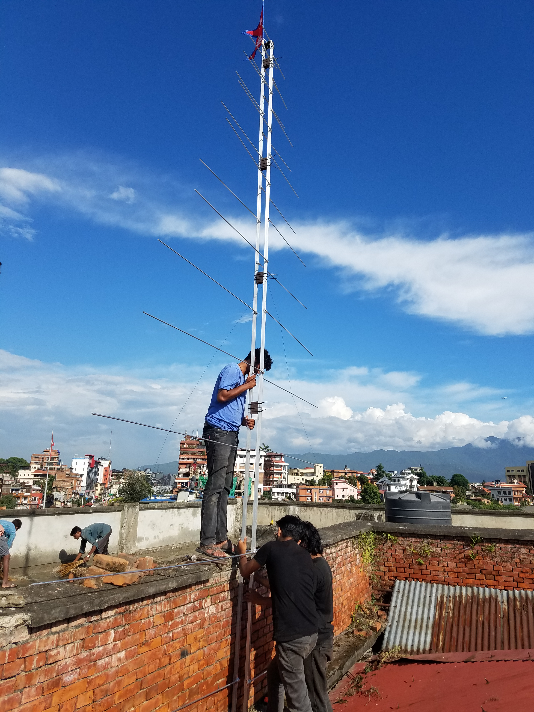
Installation Photos/20190806_160441.jpg
