Bot-Ro-Bot/Minor-Year-Project/Installation Photos/20190806_160530.jpg

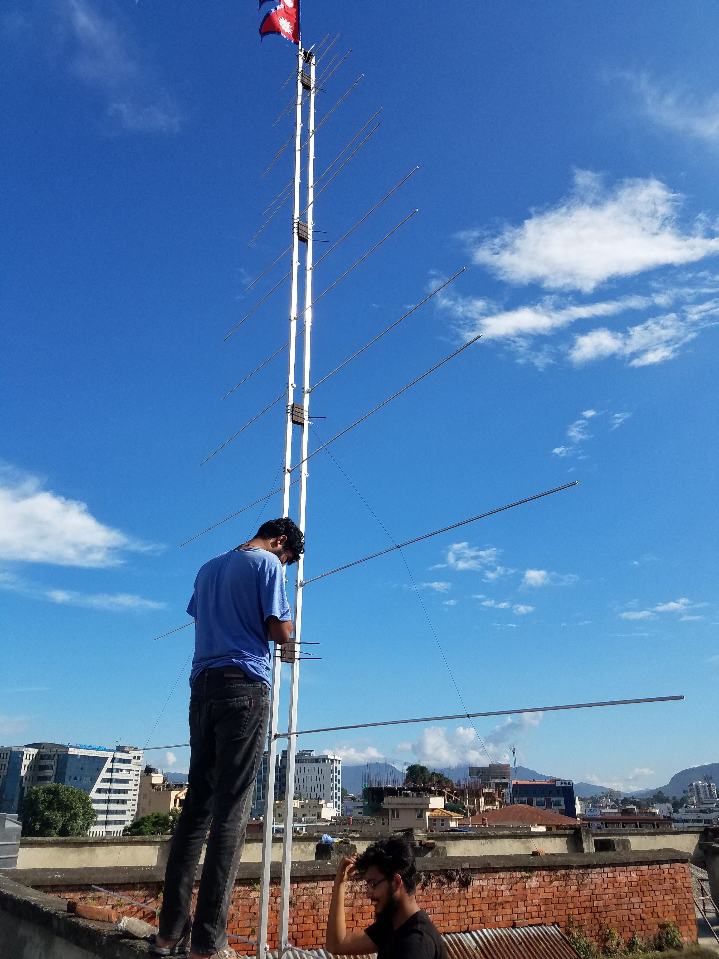
Installation Photos/20190806_160530.jpg
